ayushman-t/diseqc-rotator/(commit log)

2026-09-21 DiSEqC 1.2 dish rotator: ESP32 firmware, schematic, BOM
    ESP32 drives a DiSEqC 1.2 H-H satellite motor over coax using a GPIO-coupled
    22 kHz tone. Web UI, HTTP API and serial control.
    Claude-Session: https://claude.ai/code/session_01SKHTrEruvubxHmyvwh4CoJ
2026-09-21 Show current pointing: dead-reckoned position, true azimuth, calibration
    The firmware replays every frame it sends against the motor speed and step
    size, keeps the estimate in NVS, and reports pos, moving and az in /status.
    Web page turns the dish drawing to the current angle with the target as a
    dashed outline. Adds /gotoaz, /setpos and /cal. R is 100 ohm everywhere.
    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
2026-09-25 Minimal README with the sweep GIF on top, drop the BOM
    Claude-Session: https://claude.ai/code/session_01JG5LgsFMa2gGx1DyUw9Drv
